crengineering/dshot300-logic-analyzer-nano33iot/case/la_case.step

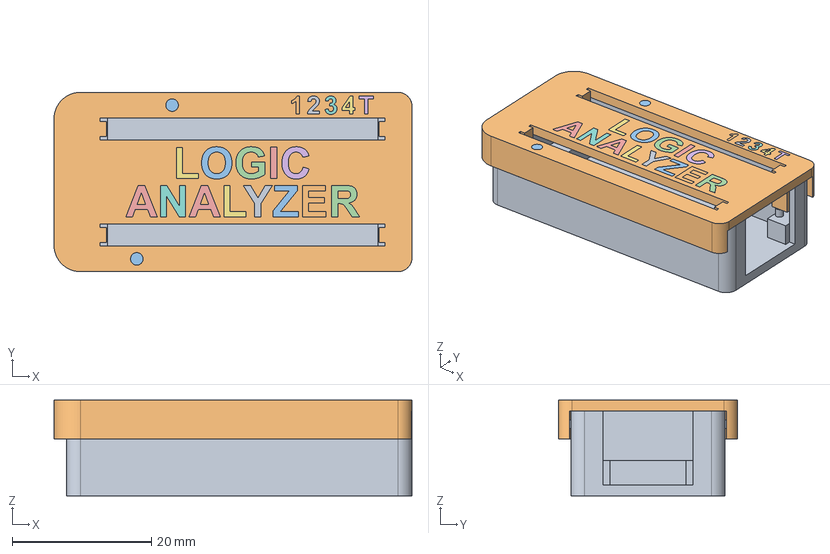
[picture p4: CAD file, 2026-10-19]
case/la_case.step
51.5 x 25.8 x 13.8 mm
