crengineering/dshot300-logic-analyzer-nano33iot/case/la_case_bambu.3mf

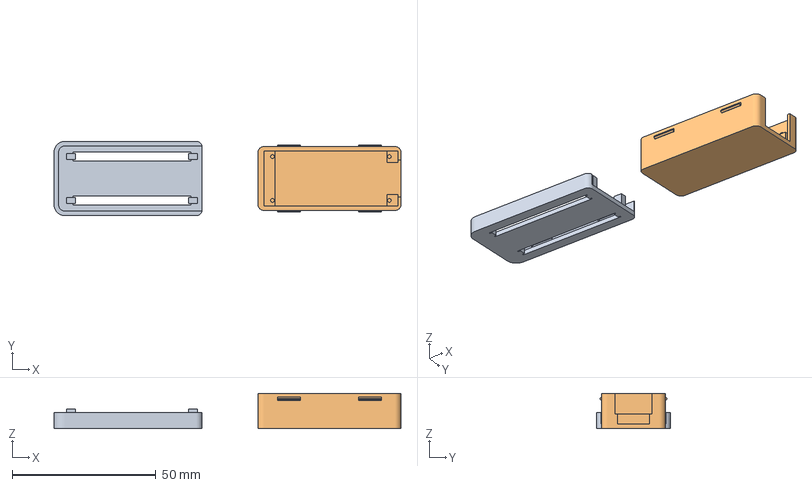
[picture p5: CAD file, 2026-10-19]
case/la_case_bambu.3mf
120.6 x 25.8 x 12.2 mm
Lid
Base
