crengineering/dshot300-logic-analyzer-nano33iot/case/la_case_Label.stl

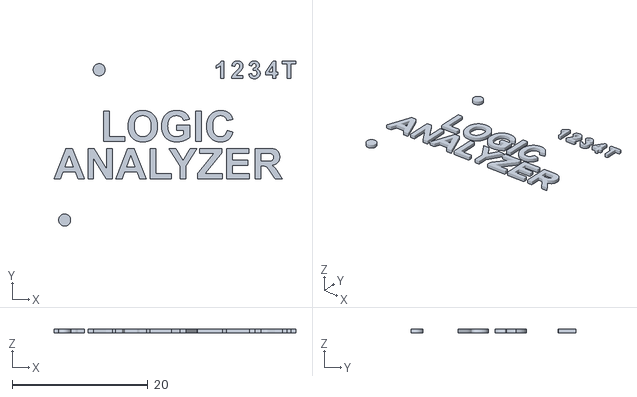
[picture p6: CAD file, 2026-10-19]
case/la_case_Label.stl
35.6 x 24.3 x 0.6
