crengineering/dshot300-logic-analyzer-nano33iot/case/la_case_Lid.stl

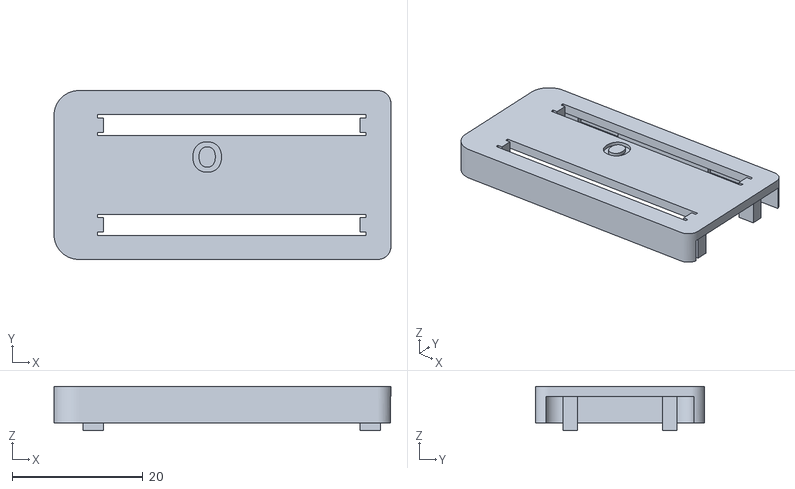
[picture p7: CAD file, 2026-10-19]
case/la_case_Lid.stl
51.5 x 25.8 x 6.80
