crengineering/dshot300-logic-analyzer-nano33iot/case/la_case_Base.stl

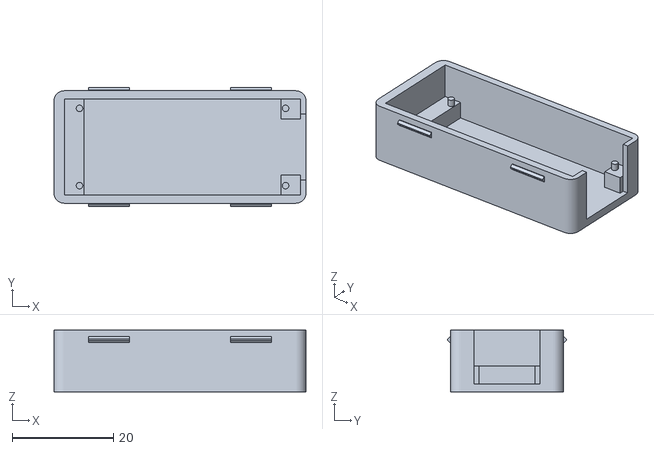
[picture p8: CAD file, 2026-10-19]
case/la_case_Base.stl
49.7 x 23.4 x 12.2
