crengineering/dshot300-logic-analyzer-nano33iot/(list of files, cad)

Other CAD files:
case/la_case.3mf
