crengineering/dshot300-logic-analyzer-nano33iot/(commit log)

2026-10-19 added files and sketch
    [la_case.3mf, la_case.step, la_case_Base.stl, la_case_Label.stl, la_case_Lid.stl, la_case_bambu.3mf]
2026-10-19 Prepare for publication: standalone docs, MIT license, case rev 2
    - Remove references to the sibling flight-controller project; README,
    sketch header and GUI now describe a generic DShot300 analyzer
    - Add MIT LICENSE, requirements.txt, commit the Arduino sketch
    - Case: use the Nano 33 IoT datasheet dimensions (43.16 x 17.77 mm),
    locating pins into the PCB holes, lid bosses instead of corner posts,
    3.5 mm standoff, wider USB notch; regenerated STL/STEP/3MF/Bambu project
    - Case README translated to English
    [la_case.3mf, la_case.step, la_case_Base.stl, la_case_Label.stl, la_case_Lid.stl, la_case_bambu.3mf]
2026-10-19 Case: open USB end, port face flush with the case end
    - Board shifted 0.4 mm towards the USB end so the micro-USB face is flush
    with the outer face of the base wall
    - Lid plate ends flush with the base wall at the USB end; skirt is now
    U-shaped (long sides + far end), no skirt notch needed
    - Slots, bosses, pins and label follow the board offset
    - Regenerated STL/STEP/3MF, Bambu project and preview; case README updated
    [la_case.3mf, la_case.step, la_case_Base.stl, la_case_Label.stl, la_case_Lid.stl, la_case_bambu.3mf]
2026-10-19 Case rev 3: 45.5 x 18 mm board, measured on the real Nano
    The datasheet drawing (43.16 x 17.77 mm) produced a pocket too short for
    the board. Pocket now 46.5 x 19.0 mm (0.5 mm clearance per side), end
    ledges 3.8 mm so the locating pins sit fully on them. Hole grid still the
    standard 40.64 x 15.24 mm, assumed centred. Regenerated STL/STEP/3MF,
    Bambu project, preview; README updated.
    [la_case.3mf, la_case.step, la_case_Base.stl, la_case_Label.stl, la_case_Lid.stl, la_case_bambu.3mf]
2026-10-19 Case: cut the USB-end ledge away under the socket
    The micro-USB shell tabs stick out below the PCB, so the +X ledge is
    relieved 11 mm wide (usbReliefW) down to the floor. Only the two pin
    pads remain at that end. Exports, Bambu project and preview regenerated.
    [la_case.3mf, la_case.step, la_case_Base.stl, la_case_bambu.3mf]
2026-10-19 Case: notch the lid plate over the USB opening
    The lid plate now has a 13 mm wide, 3 mm deep notch (usbLidD) between
    the +X bosses, so base and lid form a U-slot open at the top and the
    cable overmold is not limited in height. Exports regenerated.
    [la_case.3mf, la_case.step, la_case_Lid.stl, la_case_bambu.3mf]
2026-10-19 Revert "Case: notch the lid plate over the USB opening"
    This reverts commit e4e39f2aa61ddcb55e6e924beeae96a38626a44a.
    [la_case.3mf, la_case.step, la_case_Lid.stl, la_case_bambu.3mf]
2026-10-19 Case: USB wall opening runs down to the floor level
    The lip below the USB notch is removed; the opening is 13 mm wide from
    the floor level to the rim (usbDown dropped). Exports regenerated.
    [la_case.3mf, la_case.step, la_case_Base.stl, la_case_bambu.3mf]
2026-10-19 Case: pin marks on the lid (1-4, T, GND dots) in the label filament
    Bold 3 mm characters beside the D12..D8 slot, one per pin, and a dot at
    each GND pin, inlaid 0.6 mm like the main label. Exports regenerated.
    [la_case.3mf, la_case.step, la_case_Label.stl, la_case_Lid.stl, la_case_bambu.3mf]
2026-10-19 Case: pin marks on the other row, centred in the strip, GND dots fixed
    The 1-4/T marks move to the +Y row (markRow), glyphs 2.6 mm, centred
    between slot and lid edge. The GND dots were extruded from the wrong
    start plane and floated above the lid; they are now inlaid like the text.
    [la_case.3mf, la_case.step, la_case_Label.stl, la_case_Lid.stl, la_case_bambu.3mf]
2026-10-19 GUI: one Bidir DShot switch instead of per-channel inv ticks
    All DShot channels follow the one checkbox in the top bar; toggling it
    also swaps the trigger between frame start and frame start inv. Saved
    as meta "bidir"; old captures with the per-channel "inv" string still load.
    [logic_gui.py]
2026-10-19 README: photo of the printed case
2026-10-19 README: CAD preview next to the photo of the printed case
2026-10-19 README: crop the case photo to the preview's aspect ratio
2026-10-19 README: CAD preview on the left, photo on the right
